yongiluu/CDIO/conexiones esp32.pdf

## Machomacho

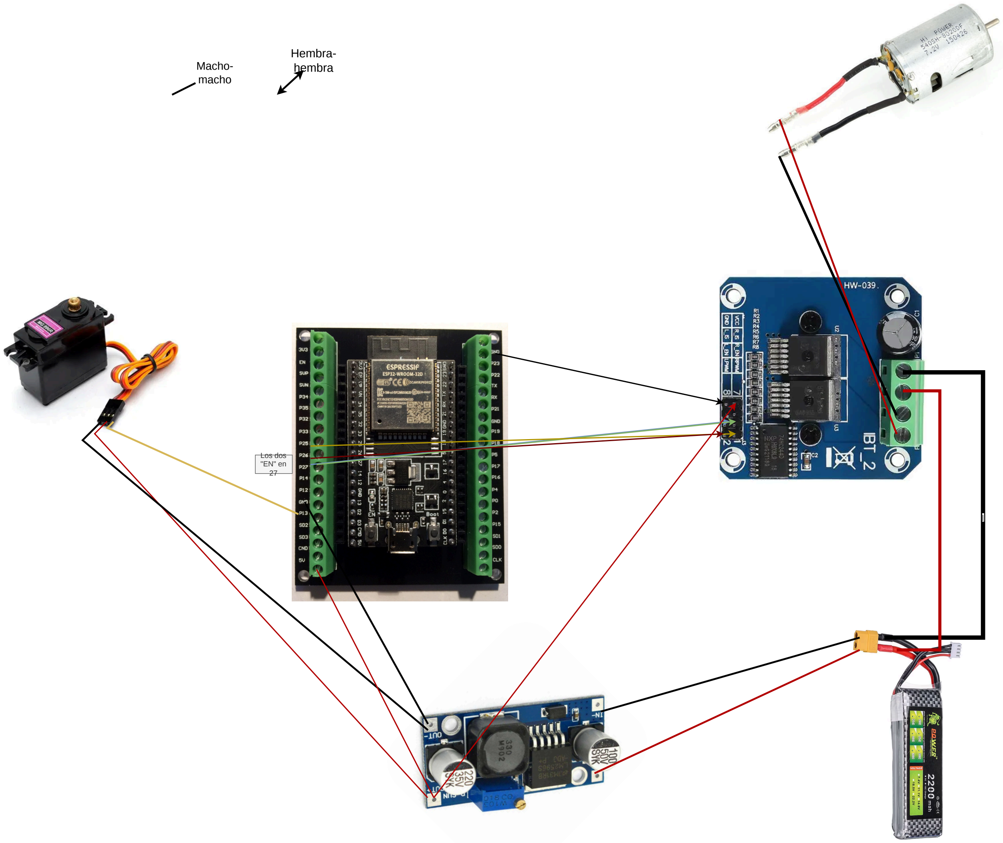
[picture p1: page 1]

## Hembrahembra

Los dos
"EN" en
27

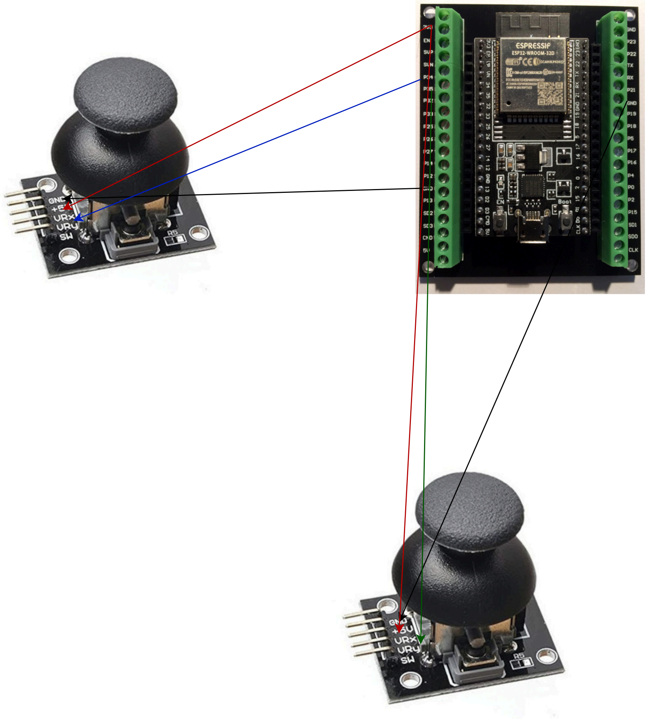
[picture p2: page 2]
