yongiluu/CDIO/(commit log)

2026-09-27 Primer commit: Codigo base ESP-NOW para carrito y control remoto
2026-09-28 Simplifica codigo para prueba con LEDs integrados
2026-09-28 Renombra carpetas a RX/TX y actualiza entorno a ESP32 (esp32dev)
2026-09-28 Arregla parpadeo de LEDs forzando el Pin 2 y aumentando el delay
    [main.cpp]
2026-10-12 Implementacion completa CDIO: transmision ESP-NOW con joystick deadzone, receptor BTS7960 nativo y servo de direccion, esquemas y documentacion
2026-10-13 Actualiza mapeo de direccion -40 a +40 grados y limpia salida del monitor serie
2026-10-13 Agrega failsafe en el receptor y calibracion automatica del centro de joysticks
    Claude-Session: https://claude.ai/code/session_018AYSukB1x5QrxCq6JawLui
2026-10-15 Corrige arranque inseguro del motor y filtra paquetes ESP-NOW ajenos
    - RX: fija EN/RPWM/LPWM en LOW al inicio del setup (antes quedaban flotando >1 s)
    - RX: control del motor desde el loop, rampa de aceleracion y aviso de brownout
    - RX/TX: clave 0xCD10 en el paquete para ignorar otros dispositivos ESP-NOW
    - TX: promedio de lecturas del joystick y validacion del centro calibrado
    - README: actualiza la estructura MensajeDatos
2026-10-21 Amplia el giro del servo y agrega curva expo a los joysticks
    - RX: el angulo -40..40 se escala a +-GIRO_MAX_SERVO (60 grados) con CENTRO_SERVO ajustable
    - TX: curva expo en velocidad (0.6) y direccion (0.5) para respuesta suave cerca del centro
2026-10-21 Agrega lectura de bateria con divisor de voltaje y telemetria al control
    - RX: mide la bateria en GPIO 34 (divisor 50k/10k, factor 6) cada 500 ms,
    detecta 2S/3S y avisa bajo 3,5 V por celda
    - RX: envia la telemetria (CLAVE 0xCD11) de vuelta al control por ESP-NOW
    - TX: recibe la telemetria y muestra el voltaje en el monitor serie
2026-10-21 Bloquea el control si falla la calibracion de los joysticks
    Antes, un centro fuera de rango se reemplazaba por 2048 y una lectura
    mala (joystick desconectado) se enviaba como movimiento (Vel -100).
    Ahora el TX queda bloqueado y envia siempre Vel 0 / Ang 0.
2026-10-21 Limita y suaviza el servo; muestra la bateria solo en el control
    - RX: GIRO_MAX_SERVO baja a 45 grados para no chocar con el tope de la direccion
    - RX: rampa del servo (PASO_SERVO 5 grados cada 10 ms), solo escribe si cambia
    - RX: deja de imprimir la bateria; solo la envia como telemetria
    - TX: muestra voltaje, celdas (2S/3S) y aviso de bateria baja
2026-11-12 Agrega fast brake con click del stick de potencia y adapta el codigo al core ESP32 3.x
    - TX: boton SW del joystick de velocidad en GPIO 32 (INPUT_PULLUP); un click
    activa el freno (min 0,5 s, se libera con boton suelto y stick al centro).
    - Nuevo campo freno en MensajeDatos (hay que flashear TX y RX).
    - RX: freno dinamico con EN en HIGH y RPWM = LPWM = 0; el failsafe lo libera.
    - Compatibilidad core 3.x: ledcAttachChannel/ledcWrite por pin y callbacks
    ESP-NOW nuevos (esp_now_recv_info_t, esp_now_send_info_t en IDF 5.5),
    manteniendo el codigo del core 2.x con #if.
    Claude-Session: https://claude.ai/code/session_01SvAQq8S8J263RDFASz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
2026-11-12 Documenta el fast brake y la compatibilidad con el core 3.x en el README
    Claude-Session: https://claude.ai/code/session_01SvAQq8S8J263RDFASze2pG
